strickyak/copico-centipede/doc/talk-cocofest-2026/images/PXL_20260423_184708554.jpg

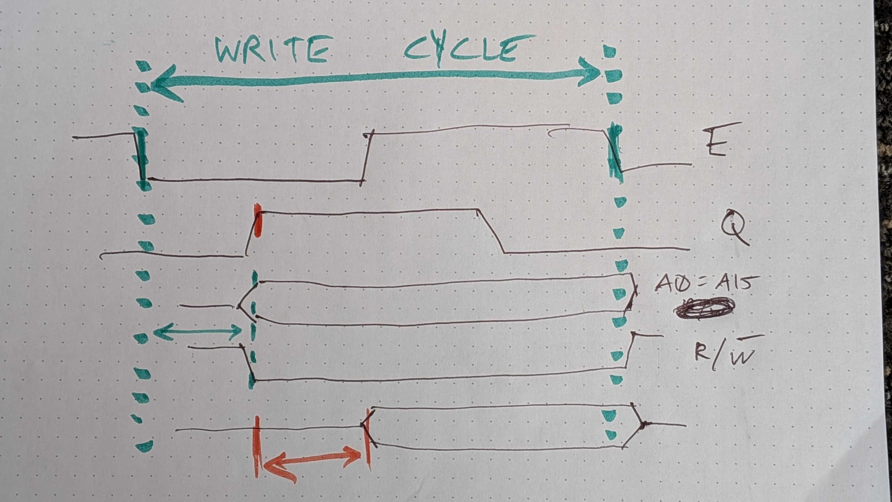
doc/talk-cocofest-2026/images/PXL_20260423_184708554.jpg
