strickyak/copico-centipede/centipede-32z/centipede-32d.3d.png

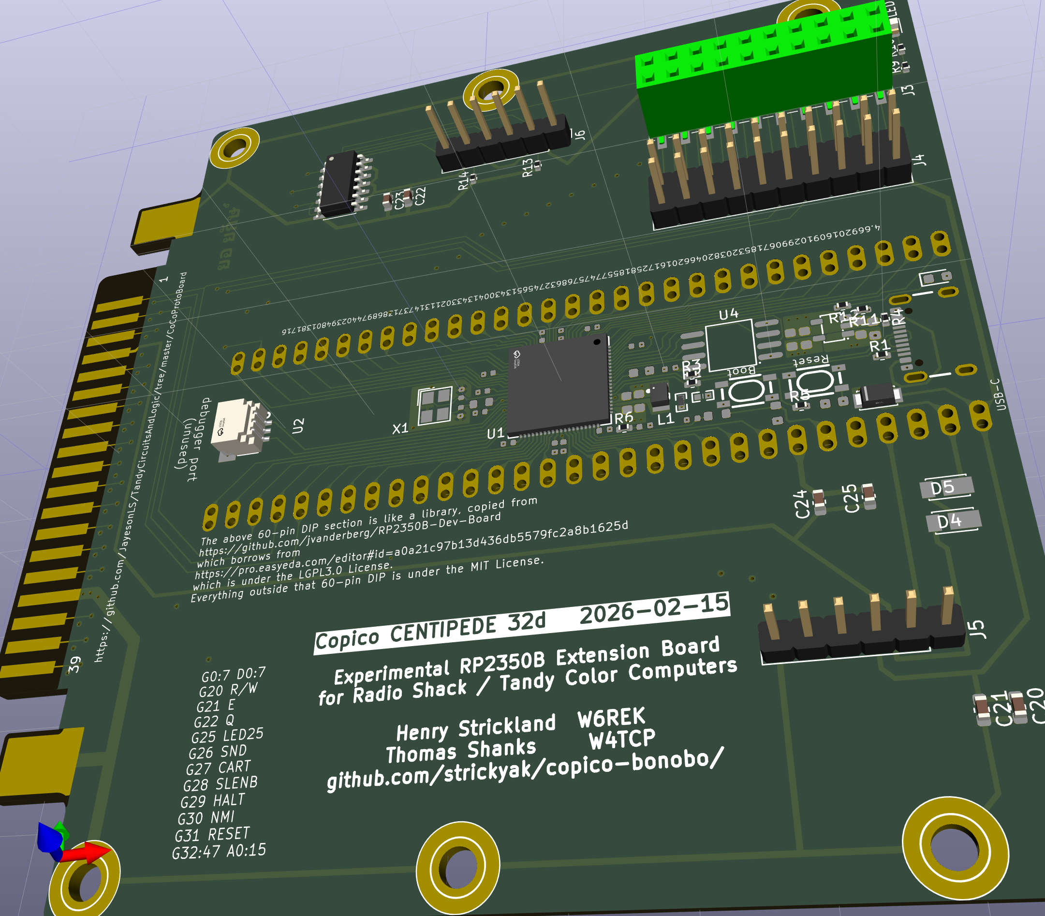
centipede-32z/centipede-32d.3d.png
