strickyak/copico-centipede/centipede-32z/centipede-32z-3d.png

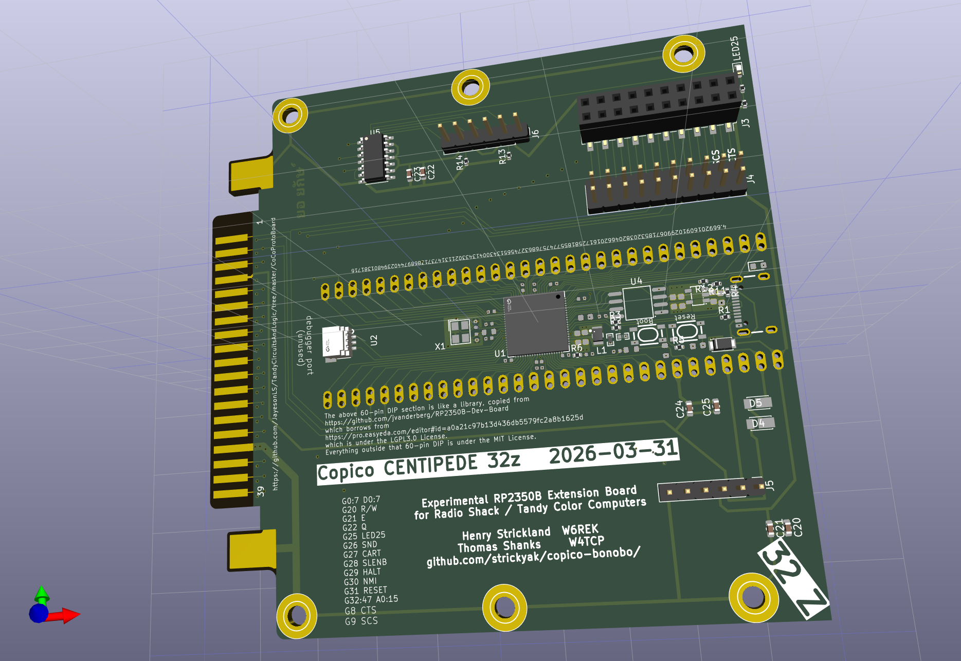
centipede-32z/centipede-32z-3d.png
