strickyak/copico-centipede/(commit log)

2026-07-04 cleanup & trace all reads & writes except $FFFF
2026-07-09 attempts to postpone HALT cause DIR to fail
    future: try marking the DISK operation,
    and have ccfifo keep track of number of pending
    DISK operations, and return it like it returns .size()
    Then if no disk operations, try avoiding Halt.
    Or somehow else, synchronize the DISK status reads
    in the foreground with completion of the DISK commands
    in the background.
    [centipede.cpp]
2026-07-15 slot code for littlefs, unused.
2026-07-16 usb_pipeline. COBS for PC->Pico. littlefs.
2026-07-17 mount / create littlefs on boot
2026-07-17 capture ~command and send to pico for eval
2026-07-17 slot tcl6.7c to firmware
2026-07-18 1) orchestra 90; 2) dos_hack for n9L1 boot, not working
    [centipede.cpp]
2026-07-22 fixes floppy if SLOW; but some cycle updates missing, in SLOW and MEDIUM
    [centipede.cpp]
2026-07-22 fix lost write cycles over USB
    [centipede.cpp]
2026-07-23 pmode 4 console works. funny cmd=141 bug but DEFANGed.
    [centipede.cpp, gspoon.h]
2026-07-23 cobs for firmware->tether. cycle tracing broken.
    [centipede.cpp, flash-label.h, gspoon.h]
2026-07-25 Fix floppy write sector: 5 race conditions and NMI timing
    floppy.h:
    - Snapshot latch/track/sector in WriteData at byte 256, not at command
    time. Disk BASIC writes $FF40 (latch) AFTER $FF48 (command), so
    the latch value is stale when the command fires.
    - memcpy floppy_buf into floppy_write_buf shadow buffer at byte 256.
    After NMI, the CoCo immediately starts writing the next sector's
    data into floppy_buf, clobbering data before the background can
    transmit it.
    - Reset floppy_ptr before NMI in WriteData to prevent duplicate
    FG2BG_W_256 triggers from stray bytes.
    - Remove floppy_ptr reset from background 0xA0 handler. The foreground
    WriteCommand already resets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
    [centipede.cpp]
2026-07-26 Update ls command with Unix-like arguments (-a, -l, -d) and multiple targets
    - dir_cmd now handles any number of target arguments, defaulting to '.'
    - Added -a option to reveal hidden files (names starting with '.')
    - Added -l option to print file sizes in bytes
    - Added -d option to list directories themselves, not their contents
    - Sorts directory contents lexically using C strcmp
    - Prefixes directory listings with headers when multiple arguments are given
2026-07-26 Support running without USB tether (untethered CoCo2 operation)
    - flash-label.h: Replace blocking while(!stdio_usb_connected()) loop with
    early return, so firmware boots immediately without USB.
    - cobs_tx.h: Add usb_tether_ok() helper wrapping stdio_usb_connected().
    Guard cobs_putchar and cobs_printf to silently drop output when USB is
    disconnected. Detailed comments explain all the consequences.
    - floppy.h: Guard read sector to return Lost Data error (status 0x04)
    instead of deadlocking on ReceiveSectorData. Guard write sector
    similarly instead of sending to nowhere.
    - vfs_rpc.h: Guard vfs_rpc_call to return error response immediately
    when USB is disconnected, preventing infi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
    [centipede.cpp, flash-label.h, gspoon.h]
2026-07-26 Reset and Halt coco for 2 seconds, on pico startup.
    [centipede.cpp]
2026-07-27 Implement REPL ReadLine editing, history, and fix COBS USB polling
    Changes made:
    - Added a 20-element `std::string` history buffer to `BackgroundSpoonFeeder` in `gspoon.h`.
    - Implemented robust ReadLine-style editing in `gspoon.h` (insertion, deletion, left/right/up/down navigation using standard `\b` and spaces).
    - Fixed a destructive backspace bug in `console.h` where `\b` (8) and DEL (127) would erase the character underneath instead of just moving the cursor left.
    - Replaced the brittle `sleep_ms(10)` sequence wait for `ESC` parsing with a robust, non-blocking `ansi_state` machine in `gspoon.h`.
    - Added a `while(true)` loop inside `tcl_io::poll_key` to actively skip COBS framing bytes (`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
    [gspoon.h]
2026-07-28 Fix zip get stack smash by allocating miniz inflator on heap
    [centipede.cpp]
2026-07-28 Implement visual edit command in Tcl
    Supported special keystrokes:
    - Arrow keys: Navigate cursor
    - Enter: Split lines/insert newline
    - Backspace: Delete character or join lines
    - Ctrl-S: Save and quit
    - Ctrl-Q: Quit without saving
    - Ctrl-A: Move to beginning of line
    - Ctrl-E: Move to end of line
    - Home: Move to top of file
    - End: Move to bottom of file
    - PageUp/PageDown: Scroll 20 lines up/down
2026-07-28 Implement transparent archive mounting
    This entirely rewrites the VFS architecture to be OOP-based. Paths are now recursively resolved via dynamically instantiated VfsNode instances (e.g. LittleFsNode, TetherFsNode, ZipArchiveNode).
    - Resolves zip paths contextually: '/etc/cal.zip' resolves to a file, whereas '/etc/cal.zip/' wraps into a ZipArchiveNode and acts as a directory.
    - Adapts LittleFS, Tether VFS RPC, and Miniz APIs to conform to the VfsNode base class methods.
    - Fixes 'zip' Tcl command panic by properly dereferencing the VfsNode raw pointer.
    - Enables AUTO_GLOB in centipede.cpp.
    [centipede.cpp]
2026-07-28 Adopt Java-like ! syntax for transparent archive mounting
2026-07-29 sample expect scripts in firmware/tests
2026-07-31 Fix lost write cycle records: flow control bug + diagnostics
    Root cause: drain_task (core 0) called HaltOff() unconditionally at the
    top of every iteration, immediately undoing the flow-control HaltOn()
    set by FlowControlCheck() (core 1). This meant HALT was asserted and
    released in rapid alternation, never pausing the 6809 long enough for
    the fg2bg FIFO to drain. The FIFO overflowed (8192 slots) and
    PushFifoWrite silently dropped items.
    Fix: removed the unconditional HaltOff() from drain_task. Flow-control
    HALT is now managed exclusively by FlowControlCheck() on the foreground
    core, which releases HALT when the FIFO drains below the low watermark.
    Additional changes:
    - PushFifoWrite now c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
    [centipede.cpp]
2026-07-31 Filter stale non-ASCII bytes from USB input in poll_key
    When the tether reconnects to already-running firmware, the USB CDC
    receive buffer may contain stale bytes from in-flight COBS-encoded
    packets (compressed cycles, putchar, etc.). The firmware's poll_key()
    reads these via getchar_timeout_us(0) and any byte that passes the
    existing filter (skip 0x00 and 0x02) gets treated as a typed keystroke.
    The byte 0xB2 (Latin-1 ² SUPERSCRIPT TWO) was commonly seen because
    it appears in compressed cycle data. It would be echoed to the Tcl
    console and prepended to the first command, causing 'invalid command
    name' errors (e.g. '²info' instead of 'info').
    Fix: skip any byte >= 128 in poll_key, since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
2026-07-31 Add optional COBS packet checksums for data integrity
    Append a one's-complement checksum byte to every COBS packet before
    encoding. On decode, verify the checksum and silently discard packets
    that fail. This catches bit errors and partial/corrupt packets from
    USB glitches or reconnection race conditions.
    Checksum algorithm: ~(sum of all payload bytes) & 0xFF. When appended,
    the sum of all bytes including checksum equals 0xFF. This is cheap to
    compute on the RP2350 (single pass, no multiply) and catches any
    single-byte corruption.
    Firmware (v1/util/cobs.h):
    - CobsChecksum() computes the checksum
    - CobsEncodeAndTransmit() appends checksum before COBS encoding
    - CobsDecoder verifies and strip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
    [centipede.cpp]
2026-08-01 Fix arrow key parsing broken by COBS_CHECKSUMS
    When COBS_CHECKSUMS was enabled, tether payloads increased to 2 bytes (1 byte data + 1 byte checksum). This caused the COBS encoding length byte to become 0x03 instead of 0x02. The REPL raw USB poller hack (poll_key) was only ignoring 0x00 and 0x02, so it incorrectly passed the 0x03 length byte as a keystroke right before the actual keystroke. This spurious 0x03 byte aborted the ANSI escape sequence state machine when arrow keys were pressed, causing the remaining bytes like '[A' to be printed as text instead of moving the history cursor.
    Adding 0x03 to the list of skipped COBS overhead bytes fixes the issue, correctly dropping the length byte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
2026-08-01 Fix menu rendering bugs: missing blank lines, doubled hotkeys, missing spaces
    [gspoon.h]
2026-08-02 new "up dn left right esc" shifted assignments
2026-08-02 Keycode convention: move arrows to 128+, ANSI parser in tether
    - console.h: New keycode convention (128-133 for arrows/page keys).
    CoCo Left/Right stay 8(BS)/9(TAB) for compatibility.
    Removed shift_clear_map (Clear takes priority over Shift).
    - tconsole.go: ANSI escape parser in InkeyRoutine translates
    ESC sequences to single-byte keycodes 128-133. Fixed goroutine
    leak (single persistent stdin reader). LF->CR and DEL->BS in
    sendKey. Removed ^_ REBOOT handler. Widened byte filter to 1-255.
    - webserver.go: Added arrow/page key mappings to KeystrokeValue.
    - tcl_io.h: Removed LF->CR mapping (now done in tether).
    - gspoon.h: Replaced ESC state machine with direct keycode checks.
    - edito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
    [gspoon.h]
2026-08-02 Reduce coroutine stack pressure: yield instead of PumpUsbCobs
    - vfs_rpc.h: When a Coro* is available, yield to the scheduler instead
    of calling PumpUsbCobs() directly. The scheduler pumps on its own
    large stack between coro_resume() calls. When self==nullptr (most VFS
    calls), fall back to PumpUsbCobs (unavoidable).
    - floppy.h: Same — remove PumpUsbCobs from ReceiveSectorData, rely on
    scheduler pump via coro_yield.
    - coro.h: Added stack budget documentation with estimated frame sizes
    for the deepest call chain (spoon→Tcl→fs_cmd→glob→Tcl→cd→vfs_stat
    →vfs_rpc_call, ~2500 bytes of 4096). Documented rules to avoid
    overflow and how to add stack canaries for debugging.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
2026-08-03 Add centipede_abort, eliminate coroutine stack pressure, go header-only
    New file: abort.h
    - centipede_abort(msg): malloc-free abort that prints up to 32 chars
    to USB tether via COBS, validates pointer against RP2350B address
    space (SRAM 0x20000000, Flash 0x10000000), then hangs with WFI.
    - CENTIPEDE_ASSERT(cond, msg) macro.
    - extern C linkage so Pico SDK's panic trampoline can call it.
    CMakeLists.txt:
    - PICO_PANIC_FUNCTION=centipede_abort: SDK's panic() now jumps to
    our handler. Both SDK panics and Tcl panics go through the same
    malloc-free, USB-tether-output path.
    - Removed vfs_rpc.cpp from sources (folded into vfs_rpc.h).
    vfs_rpc.h:
    - Folded vfs_rpc.cpp contents (the last non-hea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
2026-08-03 Add TCL_MEM_DEBUG support and debug-malloc-oom test command
    - CMakeLists.txt: Add TCL_MEM_DEBUG=1 for Tcl memory debugging.
    - tclCkalloc.c: Guard kill(getpid(), SIGINT) with #ifndef TCL_GENERIC_ONLY;
    call panic() instead on bare metal (no signals on RP2350).
    - tcl_commands.h: Add 'centipede debug-malloc-oom' subcommand that loops
    ckalloc(256) until OOM, printing each allocation to tether. Only
    available when TCL_MEM_DEBUG is enabled.
2026-08-03 Add inverse video cursor support to the REPL
    Centralized line rendering into a `redraw_line()` lambda that handles
    drawing the character at `line_cursor` in inverse video for visibility,
    cleaning up the scattered key-printing logic in the REPL loop.
2026-08-03 Fix editor tether keystroke latency by replacing sleep_ms with coro_yield
    Previously, the editor used a blocking `sleep_ms(20)` when no keystroke was available. This blocked the entire core, preventing the foreground USB tether pump from running and pulling in keystrokes. Replacing it with a `coro_yield()` loop correctly yields execution to the firmware coroutine scheduler, ensuring USB input is processed instantly.
2026-08-03 Update menu.h: hotkeys inside brackets, ACTION cycle
2026-08-03 Update tcl commands: array, foreach, map, comb
    - array: Added 'exists', 'get', and 'set' subcommands. 'exists' checks if an array exists. 'get' returns a list of sorted keys and values. 'set' creates or updates an array from a list of key-value pairs.
    - foreach: Modified to accept a list of variables as the first argument, using its length as the iteration stride over the second argument list.
    - map: Updated identically to foreach, iterating in strides and returning a result element per stride.
    - comb: Updated identically to foreach, iterating in strides and returning all elements of the current stride if the body evaluates to true.
2026-08-04 firmware: Add boot_mode detection and 'centipede bootmode' TCL subcommand
    - Detect if CoCo2 E Clock is running on startup. If not, set boot_mode = 1.
    - If E Clock is detected, scan the PIA matrix for held keys during BackgroundSpoonFeeder initialization and set boot_mode accordingly (0-9, A-Z, BREAK, CLEAR).
    - Add std::atomic to startup_e_clock_detected for thread safety between foreground and background cores.
    - Implement 'centipede bootmode' subcommand in tcl_commands.h to query the current boot mode.
2026-08-04 firmware: Fix REPL leaking boot keystroke by priming debounce buffers
    - Remove flawed 'ignore_first_keystroke' logic which was vulnerable to switch bounce.
    - Instead, scan the PIA manually once when CoCo2 I/O becomes active and prime the 'iks' debounce buffers.
    - This makes Coco2Inkey treat the held boot key as already debounced and pressed, correctly swallowing the key until physical release.
    [gspoon.h]
2026-08-04 PicoRPC: tether makes RPC calls to Pico.
    * Added PicoRPC (Tether → Firmware RPC)
    ** Firmware side:
    pcb.h : Added RpcRequest::decode() and RpcResponse::encode() (mirroring the existing methods for the reverse direction).
    usb_pipeline.h : Added T_PICO_RPC = 181 tag, PicoRpcEvaluator struct, and wired it into PumpUsbCobs().
    tcl_io.h : Updated poll_key() filter to also exclude T_PICO_RPC packets (prevents them being eaten as keystrokes).
    pico_rpc.h
    [NEW]: Implements handle_pico_rpc_request() with a ping method that echoes back the request data.
    centipede.cpp : Added #include "pico_rpc.h".
    ** Tether side:
    tconsole.go : Added T_PICO_RPC = 181 constant and case T_PICO_RPC: dispatch.
    pi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
    [centipede.cpp]
2026-08-04 Add PicoRPC framework and quick-action tether commands
    New files missed from previous commit 8c7780955.
    - pico_rpc.h [NEW]: Firmware-side PicoRPC handler with ping, restart, reflash, and reformat methods.
    - pico_rpc.go [NEW]: Tether-side PicoRPC: EncodeRpcRequest, DecodeRpcResponse, PicoRpcCall (with timeout), PicoRpcPing, quickConnect, RunQuickAction.
    - tconsole.go: Add --quick-ping, --quick-restart, --quick-reflash, --quick-reformat flags with early-exit dispatch in main().
2026-08-05 Insert coro_yield into lots of file ops.
2026-08-06 init: centipede_config.trace_reads = false;
2026-08-06 Enhance Tcl menu command and improve REPL startup
    - menu.h: Add 'menu store' to populate centipede_config from Tcl array, and 'menu fetch' to do the reverse.
    - menu.h: Improve 'menu' error messages to list valid subcommands for missing or bad options.
    - gspoon.h: Bypass /rc/init.tcl and /rc/modeX.tcl startup scripts if boot_mode is 27 (Escape/Break key).
    - centipede_scripting_manual.md: Document the new menu store and fetch subcommands.
    [gspoon.h]
2026-08-07 rp2350_reset_standard() if RESET detected in console or not.
    [centipede.cpp, gspoon.h]
2026-08-07 Add SleepMillis and bug splash screen delay
    [centipede.cpp, gspoon.h]
2026-08-07 make console a bit faster, removing a couple of ANyStep()s
2026-08-07 Route floppy sector I/O through VFS (FLOPPY_OVER_VFS)
    When FLOPPY_OVER_VFS is defined, floppy read/write sector commands
    use the VFS layer (vfs_file_open/seek/read/write) instead of the
    dedicated C_DISK_READ/C_DISK_WRITE USB packets. This allows disk
    images to be accessed transparently via TetherFS RPC, LittleFS,
    or ZIP archives -- whatever VFS backend the path resolves to.
    Key changes:
    - Add floppy_vfs_files[4] / floppy_vfs_paths[4] for lazy-open
    VFS file handles, one per virtual drive.
    - In BackgroundFifoFloppyCommand (read) and BackgroundFifoFloppyW256
    (write), add #if FLOPPY_OVER_VFS blocks that open the disk image
    via VFS on first access, then seek+read or seek+write 2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
    [centipede.cpp]
2026-08-07 Add coroutine stack introspection; stabilize FLOPPY_OVER_VFS settings
    coro.h:
    - Add stack_base and stack_size fields to Coro struct, recorded
    by coro_create.
    - Add coro_stack_used() and coro_stack_free() which read the ARM
    SP register to measure current stack consumption. Useful for
    diagnosing stack overflow in any coroutine.
    Debugging results: with 80K stacks the floppy VFS path showed a
    consistent stk=120/81800 across many sector reads. Reverting to
    20K stacks showed stk=120/20360 — also stable. The earlier crash
    at 20K was spurious, not a stack overflow or reentrant leak.
    - Revert VFS disk paths to /pc/disk{0..3}.dsk.
    - Wrap verbose per-sector logging in #if 0 (retaine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
    [centipede.cpp]
2026-08-07 Add virtual keyboard injector (centipede type command)
    Implements 'centipede type "<string>"' Tcl command that queues keystrokes
    to be injected into the CoCo keyboard matrix after the Tcl session ends.
    The keyboard injector works by intercepting reads to PIA0 () in the
    foreground bus cycle loop. It uses a pre-compiled script of KeystrokeAction
    structs and a volatile row_response[8] table that the foreground reads
    inline (no std::function overhead). The background core advances the
    script based on 20ms tick timing and updates the response table.
    Key design decisions:
    - Direct inline check in the foreground loop (not via Readers[] array)
    because std::function dispatch was too slow for the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
    [centipede.cpp]
2026-08-07 Pass boot_mode via --quick-restart and persist across soft reboot
    - Changed --quick-restart from Bool to Uint to allow specifying boot_mode
    - Added RunQuickRestart to send the boot_mode payload via PicoRPC
    - Modified firmware PicoRPC handler to decode boot_mode payload
    - Switched boot_mode to use __uninitialized_ram with a magic check value
    (BOOT_MODE_CHECKER) so the injected boot_mode survives the soft reboot
    and skips the manual keyboard scan on the next startup
    [centipede.cpp, gspoon.h]
2026-08-09 Implement IGNORE_CASE_IN_VFS for transparent case-insensitive path resolution
2026-08-09 Update pwd command to reflect exact case of resolved directory path
2026-08-30 push fail signals. cycle log cleanup.
    [centipede.cpp]
2026-08-30 fix NMI -- all in fg, not released late in bg.
    [centipede.cpp]
2026-09-06 fix: RAMSIZ jumper installed on my CoCo 1 because I have 64K
    [gspoon.h]
