strickyak/copico-centipede/(notices)

Notices in the files:
centipede-32z/centipede-32z.kicad_pcb:
which is under the LGPL3.0 License.
Everything outside that 60-pin DIP is under the MIT License.
